zhouhow/z80prj/pcb/z80.kicad_sch

## KiCad design pcb/z80.kicad_sch (2023-06-27)

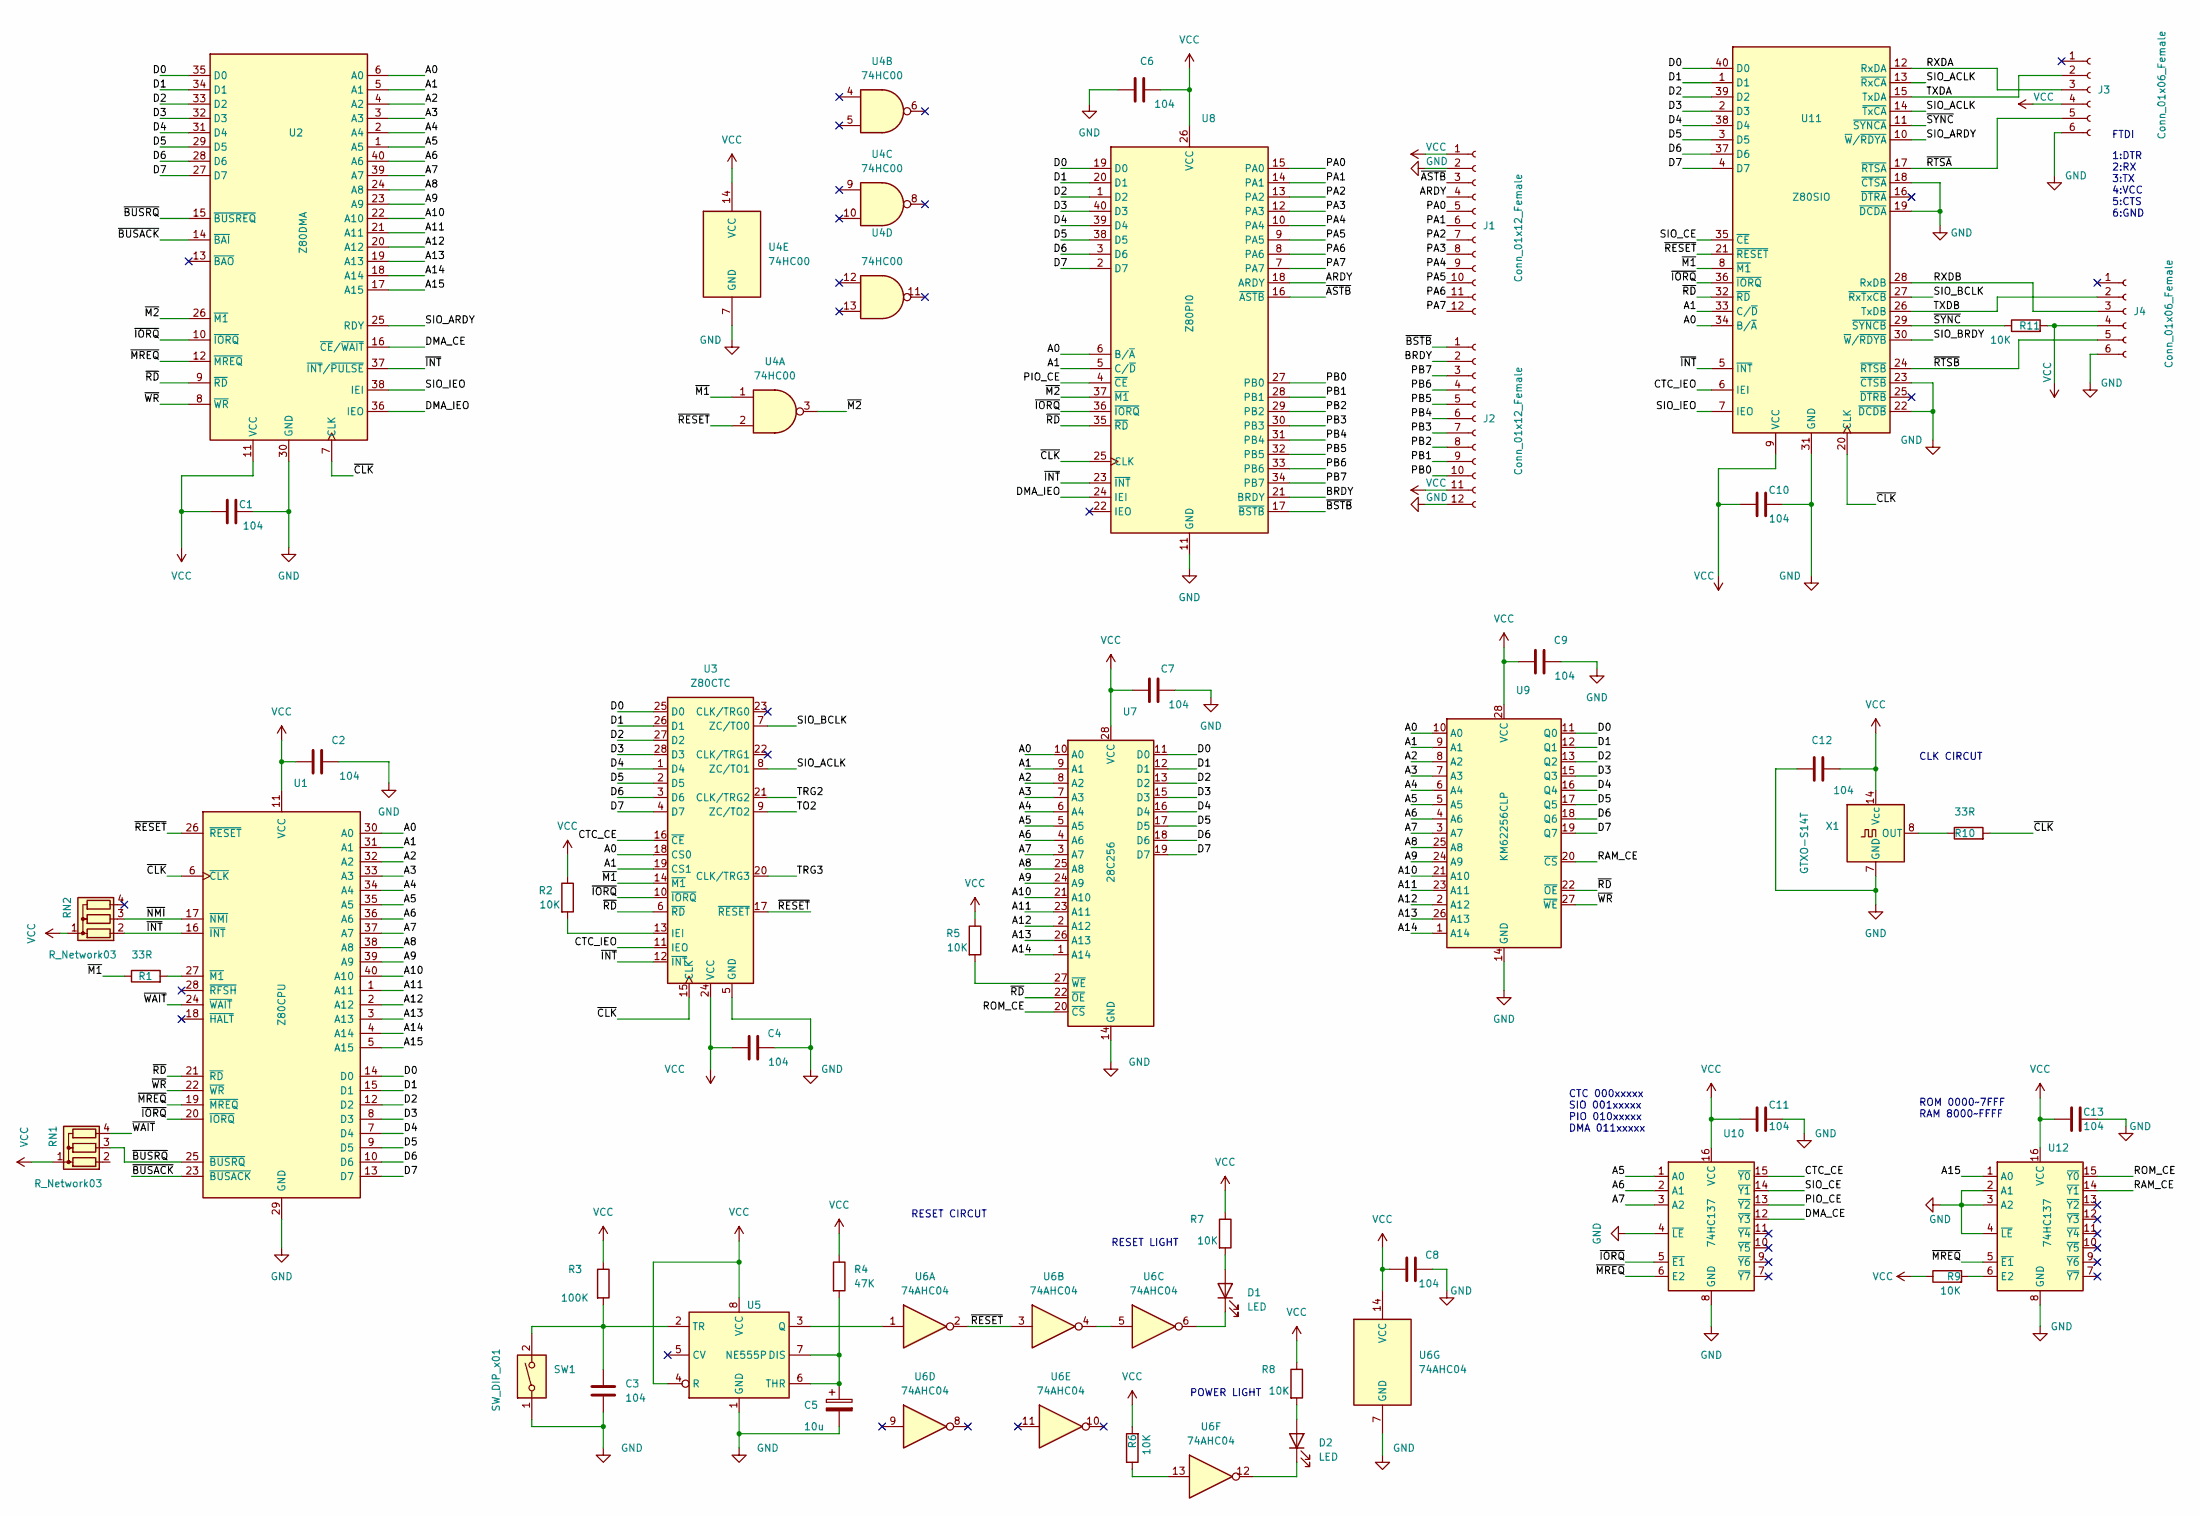
[picture p1: schematic z80.kicad_sch]

Parts:
C1, C2, C3, C4, C6, C7, C8, C9, C10, C11, C12, C13: 104; C_Disc_D4.7mm_W2.5mm_P5.00mm
C5: 10u; CP_Radial_Tantal_D5.5mm_P2.50mm
D1, D2: LED; LED_D3.0mm
J1, J2: Conn_01x12_Female; PinHeader_1x12_P2.54mm_Vertical
J3, J4: Conn_01x06_Female; PinHeader_1x06_P2.54mm_Vertical
R1, R10: 33R; R_Axial_DIN0207_L6.3mm_D2.5mm_P10.16mm_Horizontal
R2, R5, R6, R7, R8, R9, R11: 10K; R_Axial_DIN0207_L6.3mm_D2.5mm_P10.16mm_Horizontal
R3: 100K; R_Axial_DIN0207_L6.3mm_D2.5mm_P10.16mm_Horizontal
R4: 47K; R_Axial_DIN0207_L6.3mm_D2.5mm_P10.16mm_Horizontal
RN1, RN2: R_Network03; R_Array_SIP4
SW1: SW_DIP_x01; SW_PUSH_6mm
U1: Z80CPU; DIP-40_W15.24mm
U2: Z80DMA; DIP-40_W15.24mm
U3: Z80CTC; DIP-28_W15.24mm
U4: 74HC00; DIP-14_W7.62mm
U5: NE555P; DIP-8_W7.62mm
U6: 74AHC04; DIP-14_W7.62mm
U7: 28C256; DIP-28_W15.24mm
U8: Z80PI0; DIP-40_W15.24mm
U9: KM62256CLP; DIP-28_W15.24mm
U10, U12: 74HC137; DIP-16_W7.62mm
U11: Z80SIO; DIP-40_W15.24mm
X1: GTXO-S14T; Oscillator_DIP-14

Connections:
A0: U1.30 (A0), U2.6 (A0), U3.18 (CS0), U7.10 (A0), U8.6 (B/~A), U9.10 (A0), U11.34 (B/~A)
A1: U1.31 (A1), U2.5 (A1), U3.19 (CS1), U7.9 (A1), U8.5 (C/~D), U9.9 (A1), U11.33 (C/~D)
A2: U1.32 (A2), U2.4 (A2), U7.8 (A2), U9.8 (A2)
A3: U1.33 (A3), U2.3 (A3), U7.7 (A3), U9.7 (A3)
A4: U1.34 (A4), U2.2 (A4), U7.6 (A4), U9.6 (A4)
A5: U1.35 (A5), U2.1 (A5), U7.5 (A5), U9.5 (A5), U10.1 (A0)
A6: U1.36 (A6), U2.40 (A6), U7.4 (A6), U9.4 (A6), U10.2 (A1)
A7: U1.37 (A7), U2.39 (A7), U7.3 (A7), U9.3 (A7), U10.3 (A2)
A8: U1.38 (A8), U2.24 (A8), U7.25 (A8), U9.25 (A8)
A9: U1.39 (A9), U2.23 (A9), U7.24 (A9), U9.24 (A9)
A10: U1.40 (A10), U2.22 (A10), U7.21 (A10), U9.21 (A10)
A11: U1.1 (A11), U2.21 (A11), U7.23 (A11), U9.23 (A11)
A12: U1.2 (A12), U2.20 (A12), U7.2 (A12), U9.2 (A12)
A13: U1.3 (A13), U2.19 (A13), U7.26 (A13), U9.26 (A13)
A14: U1.4 (A14), U2.18 (A14), U7.1 (A14), U9.1 (A14)
A15: U1.5 (A15), U2.17 (A15), U12.1 (A0)
ARDY: J1.4, U8.18 (ARDY)
BRDY: J2.2, U8.21 (BRDY)
CTC_CE: U3.16 (~CE), U10.15 (~Y0)
CTC_IEO: U3.11 (IEO), U11.6 (IEI)
D0: U1.14 (D0), U2.35 (D0), U3.25 (D0), U7.11 (D0), U8.19 (D0), U9.11 (Q0), U11.40 (D0)
D1: U1.15 (D1), U2.34 (D1), U3.26 (D1), U7.12 (D1), U8.20 (D1), U9.12 (Q1), U11.1 (D1)
D2: U1.12 (D2), U2.33 (D2), U3.27 (D2), U7.13 (D2), U8.1 (D2), U9.13 (Q2), U11.39 (D2)
D3: U1.8 (D3), U2.32 (D3), U3.28 (D3), U7.15 (D3), U8.40 (D3), U9.15 (Q3), U11.2 (D3)
D4: U1.7 (D4), U2.31 (D4), U3.1 (D4), U7.16 (D4), U8.39 (D4), U9.16 (Q4), U11.38 (D4)
D5: U1.9 (D5), U2.29 (D5), U3.2 (D5), U7.17 (D5), U8.38 (D5), U9.17 (Q5), U11.3 (D5)
D6: U1.10 (D6), U2.28 (D6), U3.3 (D6), U7.18 (D6), U8.3 (D6), U9.18 (Q6), U11.37 (D6)
D7: U1.13 (D7), U2.27 (D7), U3.4 (D7), U7.19 (D7), U8.2 (D7), U9.19 (Q7), U11.4 (D7)
DMA_CE: U2.16 (~CE/~WAIT), U10.12 (~Y3)
DMA_IEO: U2.36 (IEO), U8.24 (IEI)
GND: C1.2, C2.2, C3.2, C4.2, C5.2, C6.2, C7.2, C8.2, C9.2, C10.2, C11.2, C12.1, C13.2, J1.2, J2.12, J3.6, J4.6, SW1.1, U1.29 (GND), U2.30 (GND), U3.5 (GND), U4.7 (GND), U5.1 (GND), U6.7 (GND), U7.14 (GND), U8.11 (GND), U9.14 (GND), U10.4 (~LE), U10.8 (GND), U11.18 (~CTSA), U11.19 (~DCDA), U11.22 (~DCDB), U11.23 (~CTSB), U11.31 (GND), U12.2 (A1), U12.3 (A2), U12.4 (~LE), U12.8 (GND), X1.7 (GND)
unnamed: C3.1, R3.2, SW1.2, U5.2 (TR)
unnamed: C5.1, R4.2, U5.6 (THR), U5.7 (DIS)
unnamed: D1.1 (K), U6.6
unnamed: D1.2 (A), R7.2
unnamed: D2.1 (K), U6.12
unnamed: D2.2 (A), R8.2
unnamed: R1.2, U1.27 (~M1)
unnamed: R2.2, U3.13 (IEI)
unnamed: R5.2, U7.27 (~WE)
unnamed: R6.1, U6.13
unnamed: R9.2, U12.6 (E2)
unnamed: R10.1, X1.8 (OUT)
unnamed: U5.3 (Q), U6.1
unnamed: U6.4, U6.5
PA0: J1.5, U8.15 (PA0)
PA1: J1.6, U8.14 (PA1)
PA2: J1.7, U8.13 (PA2)
PA3: J1.8, U8.12 (PA3)
PA4: J1.9, U8.10 (PA4)
PA5: J1.10, U8.9 (PA5)
PA6: J1.11, U8.8 (PA6)
PA7: J1.12, U8.7 (PA7)
PB0: J2.10, U8.27 (PB0)
PB1: J2.9, U8.28 (PB1)
PB2: J2.8, U8.29 (PB2)
PB3: J2.7, U8.30 (PB3)
PB4: J2.6, U8.31 (PB4)
PB5: J2.5, U8.32 (PB5)
PB6: J2.4, U8.33 (PB6)
PB7: J2.3, U8.34 (PB7)
PIO_CE: U8.4 (~CE), U10.13 (~Y2)
RAM_CE: U9.20 (~CS), U12.14 (~Y1)
ROM_CE: U7.20 (~CS), U12.15 (~Y0)
RXDA: J3.3, U11.12 (RxDA)
RXDB: J4.3, U11.28 (RxDB)
SIO_ACLK: U3.8 (ZC/TO1), U11.13 (~RxCA), U11.14 (~TxCA)
SIO_ARDY: U2.25 (RDY), U11.10 (~W/~RDYA)
SIO_BCLK: U3.7 (ZC/TO0), U11.27 (~RxTxCB)
SIO_BRDY: U11.30 (~W/~RDYB)
SIO_CE: U10.14 (~Y1), U11.35 (~CE)
SIO_IEO: U2.38 (IEI), U11.7 (IEO)
TO2: U3.9 (ZC/TO2)
TRG2: U3.21 (CLK/TRG2)
TRG3: U3.20 (CLK/TRG3)
TXDA: J3.2, U11.15 (TxDA)
TXDB: J4.2, U11.26 (TxDB)
VCC: C1.1, C2.1, C4.1, C6.1, C7.1, C8.1, C9.1, C10.1, C11.1, C12.2, C13.1, J1.1, J2.11, J3.4, J4.4, R2.1, R3.1, R4.1, R5.1, R6.2, R7.1, R8.1, R9.1, R11.2, RN1.1 (common), RN2.1 (common), U1.11 (VCC), U2.11 (VCC), U3.24 (VCC), U4.14 (VCC), U5.4 (R), U5.8 (VCC), U6.14 (VCC), U7.28 (VCC), U8.26 (VCC), U9.28 (VCC), U10.16 (VCC), U11.9 (VCC), U12.16 (VCC), X1.14 (Vcc)
~ASTB: J1.3, U8.16 (~ASTB)
~BSTB: J2.1, U8.17 (~BSTB)
~BUSACK: U1.23 (~BUSACK), U2.14 (~BAI)
~BUSRQ: RN1.3 (R2), U1.25 (~BUSRQ), U2.15 (~BUSREQ)
~CLK: R10.2, U1.6 (~CLK), U2.7 (CLK), U3.15 (CLK), U8.25 (CLK), U11.20 (CLK)
~INT: RN2.2 (R1), U1.16 (~INT), U2.37 (~INT/~PULSE), U3.12 (~INT), U8.23 (~INT), U11.5 (~INT)
~IORQ: U1.20 (~IORQ), U2.10 (~IORQ), U3.10 (~IORQ), U8.36 (~IORQ), U10.5 (~E1), U11.36 (~IORQ)
~M1: R1.1, U3.14 (~M1), U4.1, U11.8 (~M1)
~M2: U2.26 (~M1), U4.3, U8.37 (~M1)
~MREQ: U1.19 (~MREQ), U2.12 (~MREQ), U10.6 (E2), U12.5 (~E1)
~NMI: RN2.3 (R2), U1.17 (~NMI)
~RD: U1.21 (~RD), U2.9 (~RD), U3.6 (~RD), U7.22 (~OE), U8.35 (~RD), U9.22 (~OE), U11.32 (~RD)
~RESET: U1.26 (~RESET), U3.17 (~RESET), U4.2, U6.2, U6.3, U11.21 (~RESET)
~RTSA: J3.5, U11.17 (~RTSA)
~RTSB: J4.5, U11.24 (~RTSB)
~SYNC: R11.1, U11.11 (~SYNCA), U11.29 (~SYNCB)
~WAIT: RN1.4 (R3), U1.24 (~WAIT)
~WR: U1.22 (~WR), U2.8 (~WR), U9.27 (~WE)

Notes on the sheet:
POWER LIGHT
FTDI
RESET LIGHT
CLK CIRCUT
CTC 000xxxxx SIO 001xxxxx PIO 010xxxxx DMA 011xxxxx
RESET CIRCUT
ROM 0000~7FFF RAM 8000~FFFF
1:DTR 2:RX 3:TX 4:VCC 5:CTS 6:GND
