zhouhow/z80prj/(commit log)

2023-06-27 init version
    [z80.kicad_pcb, z80.kicad_sch]
2023-08-08 Makefile for Arduino-CLI Tools
